haokun12x/best-key/README.md

# BK46 — 46 键正交 / 双直驱力反馈旋钮 / TMR + 机械轴共用 / 三模 / 无线充电

> **当前状态：外壳、主板、两块旋钮小板的制作文件齐全。三块板都已 100% 布通，KiCad DRC 零错误、零未连接（主板只剩 7 处元件占位框重叠的警告）。固件未写，电子部分整体未经打样验证，BOM 编号需核对。** 详见文末「完成度与待办」。

## 1. 方案总览

| 项目 | 方案 |
|---|---|
| 配列 | 4×12 正交网格，19.05 mm 间距；左上角、右上角两格换成旋钮，共 46 键 |
| 外形 | 237.2 × 84.8 × 19.8 mm（不含脚垫），四周只比键区多 4.3 mm，圆角 R4 |
| 轴体 | 每键同时有 Kailh 热插拔座（三脚/五脚机械轴）和一颗 SOT-23 线性磁传感器（磁轴） |
| 旋钮 | 2 个，1404 级无刷外转子电机直驱 + STSPIN233 驱动 + MT6701 磁编码器；带模拟量下压识别，咔哒与震动由电机模拟 |
| RGB | 每键一颗 WS2812B-2020，正面贴装在轴体灯位，整条灯带电源可关断 |
| 显示 | 0.91" 128×32 OLED（SSD1306，38×12 mm 成品模块），嵌在前壁中央 |
| 主控 | Raytac MDBT50Q-1MV2（nRF52840）：USB、蓝牙、2.4G（配 nRF52840 接收器） |
| 固件 | RMK（用 Vial 上位机改键/层/宏）或 ZMK；**不能刷 QMK / Vial-QMK**；预留 W25Q32 外置闪存。移植要点见 `docs/firmware.md` |
| 电源 | USB-C 或 Qi 5 V 接收模块 → BQ24075 充电与路径管理 → 304060 锂电（约 800 mAh）→ XC6206 3.3 V |
| 结构 | 底壳 + 上框两件式，定位板上下各 15 段 Poron 垫片夹持（gasket），底部 8 颗 M2×18 沉头螺丝 |
| 重量 | 尼龙打印外壳约 65 g（底壳 53 + 上框 12）；FR4 定位板约 24 g |

相对最初想法的改动：

- **旋钮**：真正的侧面表冠放不下任何现成直驱电机（除非凸出约 7 mm），最终按你的决定改为左右上角各一个立式旋钮。
- **下压**：不做有行程的按压机构（1u 空间里会晃）。电机座是小板上由 4 根 FR4 梁悬挂的小岛，按压时下沉几十微米，由背面轴心的磁传感器测出，输出模拟量，接到主板复用器空余的两路。没有采用 MT6701 自带的按钮功能，因为它需要零点几毫米的轴向行程。
- **显示屏**：按你的想法放在朝向用户的前壁。从上方看是斜视角，所以选了视角最宽的 OLED。
- **无线充电**：用成品 Qi 接收贴片（线圈 + 小板，输出 5 V），焊到主板 `QI5V`/`GND` 两个焊盘，不自己设计接收电路。

## 2. 叠层（Z 向，单位 mm，从底面算起）

图：`mech/out/drawings/00_stackup_section.svg`

| 高度 | 内容 |
|---|---|
| 0 – 1.6 | 底壳底板 |
| 1.6 – 7.2 | 腔体 5.6：电池 3.2、Qi 线圈约 1.3、热插拔座向下 1.85；旋钮小板 0.6 厚，垫高 0.4（2.0 – 2.6） |
| 7.2 – 8.8 | 主板 1.6（4 层） |
| 8.8 – 12.3 | 轴体下壳 / 夹心棉 3.5 |
| 11.1 | 底壳垫片台顶面 |
| 12.3 – 13.8 | 定位板 1.5（FR4 / PC / 铝均可） |
| 15.0 | 底壳与上框分界面，上框压边底面 |
| 15.0 – 19.8 | 上框 |
| 3.8 – 17.3 | 电机（座在 0.6 小板 + 1.2 垫片上） |
| 17.6 – 31.0 | 旋钮帽，直径 18.6 |

垫片：1.5 mm 厚 Poron 条，宽 1.5 mm，贴在定位板边缘正反两面，压缩到 1.2 mm。位置见 `05_gasket_positions_x2.dxf`。

## 3. 文件清单

```
index.html                  项目主页（逐层拆解展示，可直接用 GitHub Pages 从仓库根目录发布）
site/render/, render_previews.py   主页用的外壳线稿及生成脚本
mech/params.py              所有机械尺寸的唯一来源
mech/build_case.py          外壳 CAD 脚本（CadQuery），含干涉检查
mech/build_drawings.py      各层 DXF 图纸与叠层剖面图
mech/out/*.step, *.stl      底壳 tub、上框 bezel、定位板 plate、旋钮帽 knob_cap、旋钮芯 knob_core、电机垫片 motor_spacer
mech/out/bk46_assembly.step 总装（含 PCB、电池、线圈、电机、键帽包络等参考体）
mech/out/drawings/          00 叠层剖面  01 定位板  02 上框  03/04 底壳剖面与底孔  05 垫片位置  06 夹心棉  07 腔内布局
pcb/main/bk46_main.kicad_pcb / .kicad_pro   主板（4 层 1.6 mm）
pcb/main/unconnected.txt    主板连通状态（现为全部连通）
pcb/main/fab/               主板 Gerber、钻孔、贴片坐标、四层铜 SVG
pcb/main/bom_main.csv, keymap.json, netlist.json, drc.json
pcb/knob/L, pcb/knob/R      左、右旋钮小板（2 层 0.6 mm），各含 KiCad 工程和 fab/ 制板文件
pcb/knob/bom_knob.csv, ffc_pinmap.json
pcb/gen_main.py, gen_knob.py, router.py   板子的生成脚本和自写布线器
docs/firmware.md            固件移植说明：扫描、力反馈效果、下压识别、引脚
analysis/tmr_field.py, .svg 磁轴磁场仿真
tools/                      kpy.sh（KiCad 自带 Python）、drc.sh、freeroute.py（调用 Freerouting）、write_pro.py、sympins.py、
                            patch_route.py（拆线重布补线器）、clean_dangling.py（清悬空线）、finish_main.sh（主板收尾流程）
```

重新生成（主板约 2 分钟）：

```bash
.venv/bin/python mech/build_case.py
```
```bash
tools/kpy.sh pcb/gen_main.py
```
生成器自身会剩几处连不上的线，再用收尾流程补完（约 35 分钟，结果写到 `pcb/main_fin/`，确认后复制回 `pcb/main/`）：
```bash
tools/finish_main.sh pcb/main/bk46_main.kicad_pcb pcb/main_fin
```
```bash
tools/kpy.sh pcb/gen_knob.py
```
```bash
tools/kpy.sh tools/freeroute.py pcb/knob/L/bk46_knob_L_unrouted.kicad_pcb pcb/knob/L/bk46_knob_L.kicad_pcb 200 --zones=GND:F.Cu,GND:B.Cu
```

## 4. 电路架构

### 4.1 按键扫描（机械轴、磁轴、旋钮下压共用一条链路）

- 每键：传感器 OUT →10 kΩ→ `KEY` 节点 → CD74HC4067 的一路输入；热插拔座一脚接 `KEY`，另一脚接地。
- 装磁轴时 `KEY` 跟随传感器输出，读到模拟行程；装机械轴时按下把 `KEY` 拉到 0 V。固件校准时自动判定每个键是哪种轴。
- 没有二极管矩阵，天然全键无冲。3 颗 16 选 1 复用器共 48 路：46 个键 + 2 个旋钮下压。
- 传感器电源由 P-MOS 开关控制，空闲时低频间歇上电。
- 第 1、3 行轴体旋转 180°，使 PCB 前缘、后缘和中间各空出一条没有热插拔座的带状区域放元件。

### 4.2 主控引脚

| 功能 | 引脚 | 功能 | 引脚 |
|---|---|---|---|
| MUXA / MUXB / MUXC（ADC） | P0.29 / P0.31 / P0.30 | 电池电压 | P0.04 |
| 复用器 S0–S3 | P0.27, P0.06, P0.08, P1.09 | 传感器电源使能（低有效） | P1.12 |
| 左旋钮三相 PWM | P1.10, P1.11, P1.13 | 右旋钮三相 PWM | P0.13, P0.15, P0.17 |
| 编码器 CLK / DO（共用） | P0.22 / P0.24 | 编码器片选 左 / 右 | P1.15 / P0.20 |
| 旋钮电源使能（低有效） | P0.19 | 充电状态 | P0.03 |
| LED 数据 | P0.23 | LED 电源使能（高有效） | P1.14 |
| OLED SDA / SCL | P0.14 / P0.16 | 复位 | P0.18 |
| 外置闪存 CS / CLK / MOSI / MISO | P0.02 / P0.28 / P0.26 / P0.05 | | |

每个键的复用器通道和 LED 序号在 `pcb/main/keymap.json`。旋钮下压：左 = 复用器 A 通道 0，右 = 复用器 C 通道 15。

### 4.3 旋钮模块

- **小板**：0.6 mm 双层板。电机座是 13 mm 见方的小岛，四边各由一座 3 mm 宽的桥连到 2 mm 宽的 FR4 梁上，梁两端在四角用螺丝固定在底壳凸台上。估算刚度约 190 N/mm，4 N 按压下沉约 0.02 mm，未实测。
- **角度**：MT6701QT 在小岛正面轴心，对着粘在电机轴底的径向磁铁。
- **下压**：Z 向线性磁传感器（SOT-23）在小岛背面轴心，对着粘在底壳孔里的 Ø3×0.5 磁铁。
- **驱动**：STSPIN233 在小板尾部；使能脚固定上拉到旋钮电源，整路由主板的 P-MOS 开关控制。
- **排线**：14P 0.5 mm 同向 FFC，约 30 mm。主板连接器朝后壁出线，排线向下折 180° 插入正下方的小板连接器。引脚自西向东（左旋钮）：`VSYS ×3, GND ×3, K3V3, U, V, W, PRESS, CSN, CLK, DO`；右旋钮镜像。
- 电机三相线焊在小板的 M1–M3 焊盘。
- 力反馈效果、下压算法和低功耗策略见 `docs/firmware.md`。

## 5. 外购件

| 件 | 规格 | 数量 |
|---|---|---|
| 电机 | 1404 级无刷外转子，机身 ≤ Ø18.9 × 13.5，底部 4×M2（9×9 mm），T 型桨座（2×M2 间距 5 mm） | 2 |
| 径向充磁磁铁 | Ø4×2，粘在电机轴底端 | 2 |
| 轴向充磁磁铁 | Ø3×0.5，粘在底壳电机轴心孔内，与底面齐平 | 2 |
| OLED | 0.91" SSD1306 I2C 模块，PCB 38×12 | 1 |
| 电池 | 304060 锂聚合物，带保护板，JST-SH 2P（核对极性） | 1 |
| Qi 接收 | 5 V 成品接收贴片，线圈 ≤ 48×34 | 1 |
| FFC | 14P 0.5 mm 同向，30 mm | 2 |
| 螺丝 | M2×18 沉头（上框）×8；M2×4 盘头（电机，从小板背面拧入）×8；M2×3 自攻（小板固定）×10；M2×3（定位板铜柱）×20；M2×4（旋钮帽芯）×4 | |
| 铜柱 | M2×3.5 双通 | 10 |
| 垫片 | 1.5 mm Poron，裁 1.5 mm 宽 | 30 段 |
| 接收器 | nRF52840 USB Dongle（2.4G 模式用） | 1 |

主板元件见 `pcb/main/bom_main.csv`，小板见 `pcb/knob/bom_knob.csv`。立创编号是凭记忆填的，下单前必须逐个核对。

## 6. 装配顺序

1. 旋钮模块：电机垫片夹在小板和电机之间，4 颗 M2×4 从小板背面拧进电机底座；径向磁铁粘在轴底。
2. Ø3×0.5 磁铁粘进底壳轴心孔。把旋钮模块放到底壳凸台上，四角 4 颗、尾部 1 颗自攻螺丝固定。电机螺丝头落在底壳的让位孔里，不能碰到孔壁。
3. OLED 模块从上方滑入前壁口袋固定；电池、Qi 线圈贴在底板上（位置见 `07_floor_layout.dxf`）。
4. 主板与定位板用 10 根 3.5 mm 铜柱连接，装轴，定位板边缘正反贴垫片。
5. 接好两条排线、电池、Qi、OLED 四根线，USB 一端先斜插进后壁开口，再放平。
6. 盖上框，从底面拧 8 颗 M2×18。尼龙上框用自攻方式（底孔 Ø1.7），铝上框攻 M2 牙。
7. 旋钮芯用 2 颗 M2 拧在电机转子上，压上旋钮帽。

维修时拆 8 颗底部螺丝，上框可带着键帽直接提起，内胆随后取出。

## 7. 完成度与待办

### 已验证

- 外壳各零件与 PCB、电机、电池、线圈、显示模块、键帽包络之间的干涉检查全部为 0。
- 左、右旋钮小板：100% 布通，KiCad DRC 零违规、零未连接。
- 主板：100% 布通，KiCad DRC 零错误、零未连接、零悬空线、零孔距问题（间距规则 0.10 mm，最细线 0.15 mm，过孔 0.45/0.20 mm，属 4 层板常规工艺）。剩 7 处元件占位框重叠警告（两个 FFC 座与旁边阻容、C1/C2、C3 与 J1/U138），焊盘之间不冲突，贴片前看一眼即可。
- 所有 IC 的引脚定义取自 KiCad 官方符号库。

### 主板收尾时做的取舍

- 主控模块内圈焊盘之间只容得下 0.15 mm 线，所以补线统一用 0.15 mm；电源网络（VSYS、VBUS、VBAT、K3V3、VSENSE）重布时保持原线宽，VSYS 仍为 0.5 mm。
- 部分 +3V3 走线由 0.25 mm 换成了 0.15 mm（总电流约 0.2 A 以内，压降估计 30 mV 量级）。
- `CHG`、`SWDIO` 和一小段 +3V3 共约 13 mm 走在 In1 地平面上，地平面上因此有几条短缝，对这块板的信号影响很小。
- 删掉了 15 个与其他孔重叠或间距不足的 GND/VLED 过孔（地和 LED 电源有整层平面，连通性已由 DRC 复核）。

### 未完成

1. 没有原理图，网表以生成脚本和 `netlist.json` 为准。
2. 固件未写；`docs/firmware.md` 是移植说明，不是代码。
3. BOM 里的立创编号凭记忆填写，下单前逐个核对。

### 需要打样验证的风险

1. **按键传感器选型（最重要）**。传感器在轴心南侧 3.5 mm。`analysis/tmr_field.py` 的仿真结果：

   | 传感方式 | 释放 → 触底场强 | 是否单调 | 触底前 0.5 mm 的斜率 |
   |---|---|---|---|
   | 轴心正下方 Z 向（纯磁轴板的做法） | 9.6 → 58 mT | 是 | 33 mT/mm |
   | 偏 3.5 mm，Z 向（如 TMR2617S） | 5.4 → 10.3 mT | 否 | 0.4 mT/mm |
   | 偏 3.5 mm，面内径向 | 4.1 → 19.5 mT | 是 | 8.1 mT/mm |

   应选**面内感应**的线性 TMR，敏感轴指向轴心。BOM 里暂填的 TMR2617S 是 Z 向的，在这个位置触底前约 0.7 mm 分辨不出行程。我没能确认具体的面内型号，磁铁尺寸也是假设值，建议先做 2×2 小板验证；若所选传感器敏感轴方向不同，封装要转 90°。
2. **旋钮下压灵敏度**。梁的刚度和磁场梯度都是估算，按 4 N 约 1 mT 的信号量级设计；实际偏小可把小板换成 0.4 mm 或把梁铣窄，偏大则加厚。电机磁钢对下压传感器的串扰未评估。
3. **MT6701 的 MODE 脚**按"接地 = SSI/I2C"连接，需对照手册确认。
4. **力反馈强度**约 5 mN·m 是按电机参数估算的。电机相电阻很低，固件必须限流。
5. **左旋钮 PWM 用了 P1.10/P1.11/P1.13**，属于芯片的低频引脚，出力时可能影响蓝牙灵敏度。
6. **电机尺寸**因品牌而异，`params.py` 里 `MOTOR_*` 要按实物改。
7. **RGB 供电**直接用电池电压，电量低时蓝绿光偏暗；固件要限制总电流。
8. **无线充电**的交变磁场和带磁吸的充电座会干扰磁传感器。
9. **天线**在板子中部，周围是铺铜和金属轴座，蓝牙距离会打折扣。
10. **显示模块**的显示区偏移因厂家而异，`DISP_WIN_DX` 要按实物量。
11. **正贴 2020 灯珠**能否放进轴体灯槽取决于轴体，放不下可换 1.5×1.5 的 SK6805-EC15。
12. 0.6 mm 的旋钮小板较软，贴片时需要托板。
