haokun12x/best-key/pcb/main/unconnected.txt

主板：全部连通（KiCad DRC 0 错误、0 未连接、0 悬空线、0 孔距问题）。
剩余仅有 7 处 courtyards_overlap 警告（元件占位框相互重叠，焊盘之间无冲突）。
