haokun12x/best-key/mech/out/bk46_assembly.step

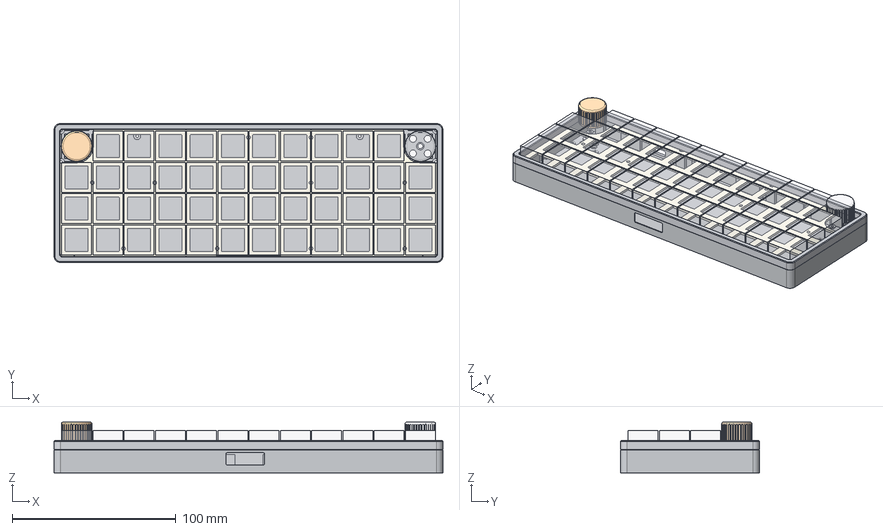
[picture p1: CAD file, 2026-11-12]
mech/out/bk46_assembly.step
237.2 x 84.8 x 31.0 mm
tub_part
bezel_part
plate_part
motor_spacer_part
knob_core_part
knob_cap_part
pcb_ref_part
sockets_ref_part
knob_cap_R_part
knob_core_R_part
motor_spacer_R_part
motor_ref_part
knob_pcb_ref_part
display_ref_part
battery_ref_part
qi_coil_ref_part
keycaps_ref_part
