haokun12x/best-key/mech/out/drawings/02_bezel_top_view.dxf

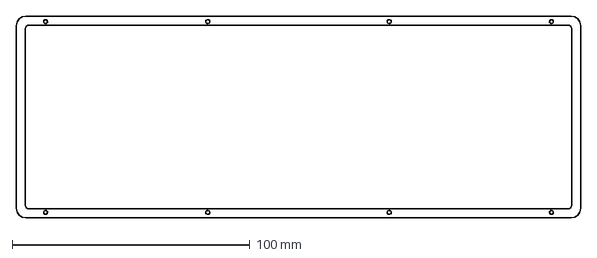
[picture p2: CAD file, 2026-11-12]
mech/out/drawings/02_bezel_top_view.dxf
237.2 x 84.8 mm
