haokun12x/best-key/mech/out/drawings/03_tub_section_z4.6.dxf

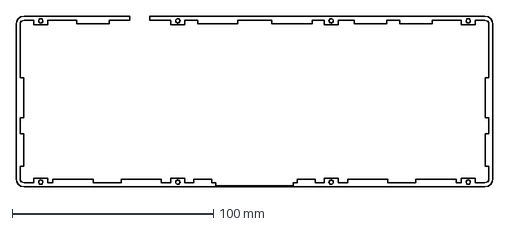
[picture p3: CAD file, 2026-11-12]
mech/out/drawings/03_tub_section_z4.6.dxf
237.2 x 84.8 mm
