haokun12x/best-key/mech/out/plate.step

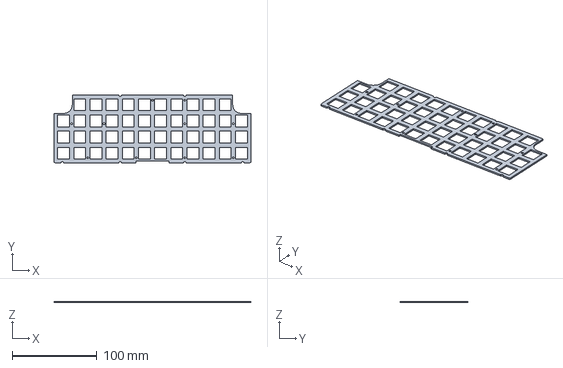
[picture p4: CAD file, 2026-11-12]
mech/out/plate.step
232.2 x 79.8 x 1.50 mm
