haokun12x/best-key/mech/out/drawings/07_floor_layout.dxf

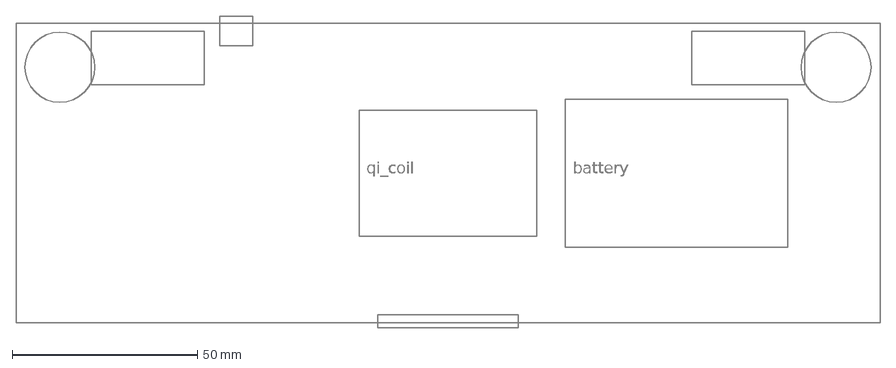
[picture p5: CAD file, 2026-11-12]
mech/out/drawings/07_floor_layout.dxf
battery
qi_coil
