haokun12x/best-key/mech/out/knob_core.step

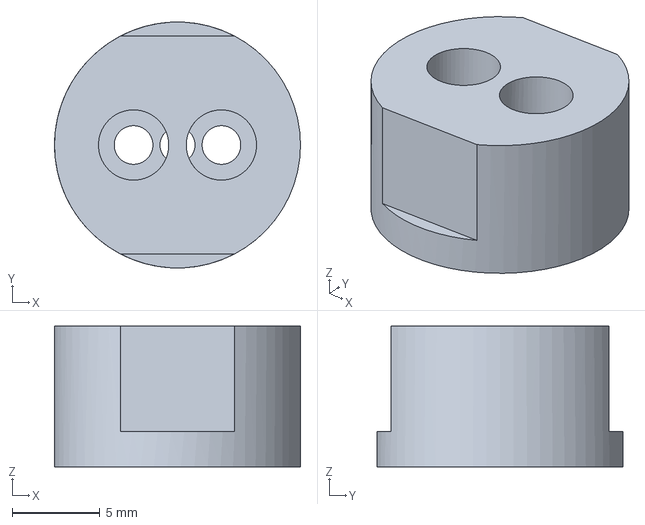
[picture p6: CAD file, 2026-11-12]
mech/out/knob_core.step
14.0 x 14.0 x 8.00 mm
