haokun12x/best-key/mech/out/drawings/06_plate_foam_3mm.dxf

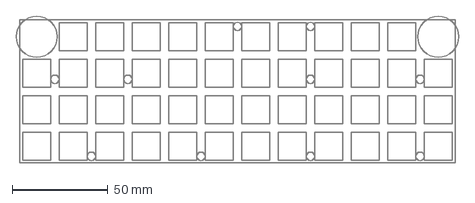
[picture p7: CAD file, 2026-11-12]
mech/out/drawings/06_plate_foam_3mm.dxf
231.0 x 76.6 mm
