haokun12x/best-key/mech/out/knob_cap.step

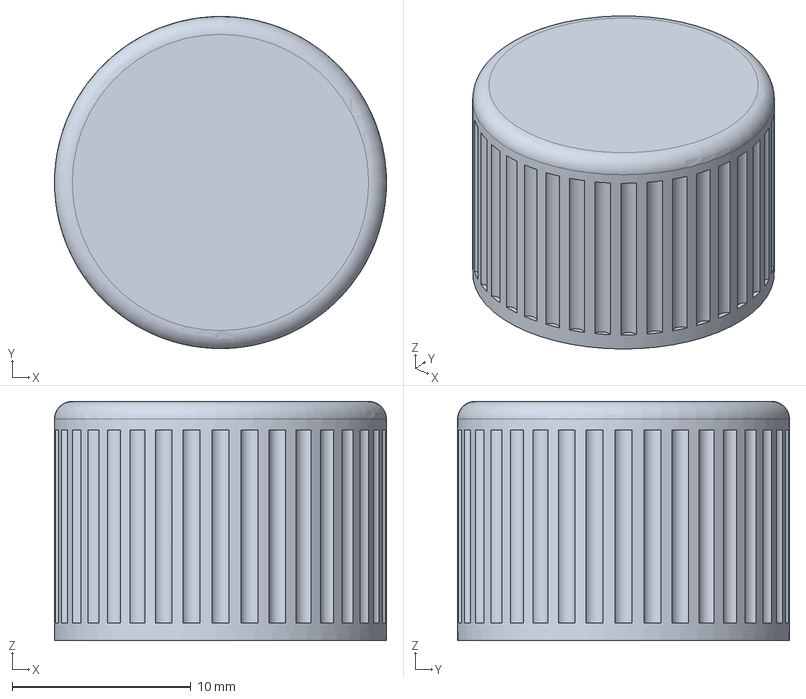
[picture p8: CAD file, 2026-11-12]
mech/out/knob_cap.step
18.6 x 18.6 x 13.4 mm
