haokun12x/best-key/mech/out/drawings/01_plate_1.5mm.dxf

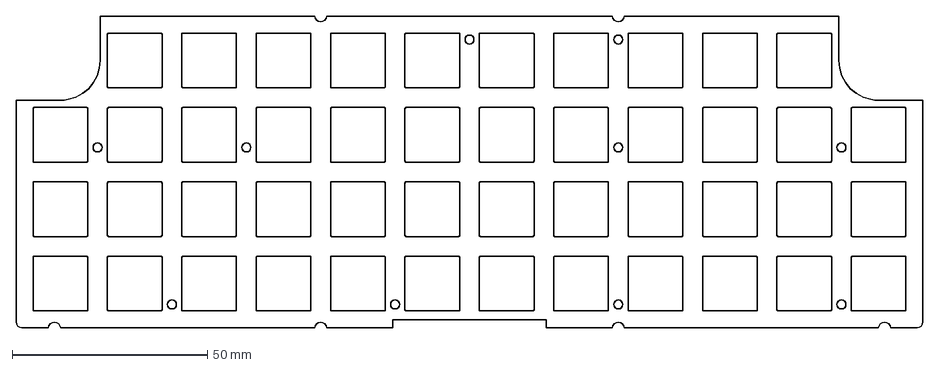
[picture p9: CAD file, 2026-11-12]
mech/out/drawings/01_plate_1.5mm.dxf
232.2 x 79.8 mm
