haokun12x/best-key/mech/out/motor_spacer.step

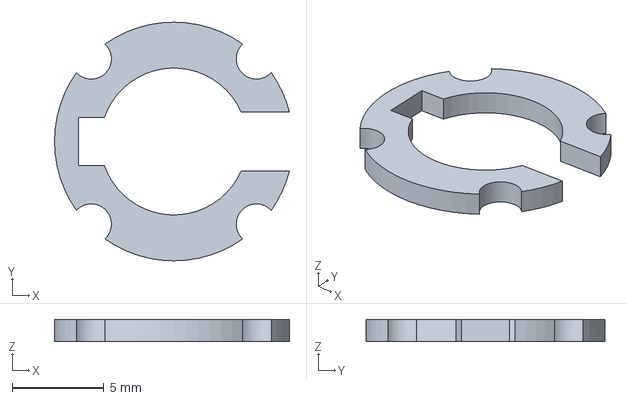
[picture p10: CAD file, 2026-11-12]
mech/out/motor_spacer.step
12.8 x 13.0 x 1.20 mm
