haokun12x/best-key/mech/out/bezel.step

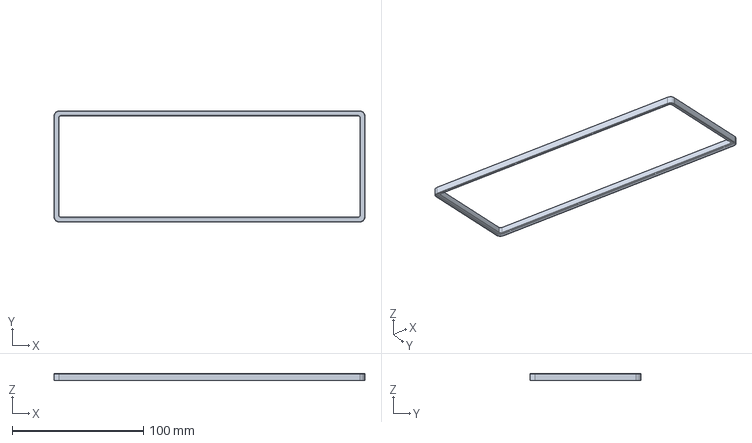
[picture p11: CAD file, 2026-11-12]
mech/out/bezel.step
237.2 x 84.8 x 5.65 mm
