haokun12x/best-key/mech/out/drawings/05_gasket_positions_x2.dxf

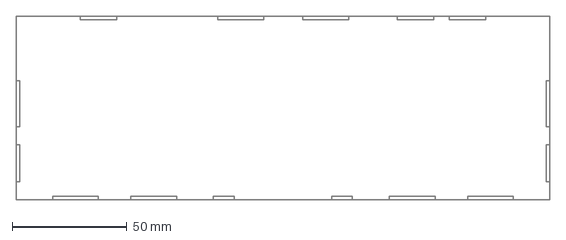
[picture p12: CAD file, 2026-11-12]
mech/out/drawings/05_gasket_positions_x2.dxf
232.2 x 79.8 mm
