haokun12x/best-key/mech/out/drawings/04_tub_floor_holes.dxf

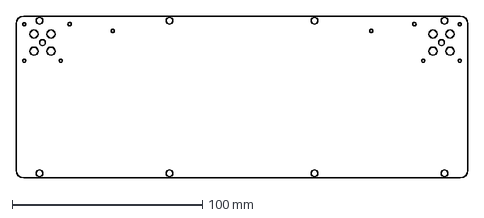
[picture p13: CAD file, 2026-11-12]
mech/out/drawings/04_tub_floor_holes.dxf
237.2 x 84.8 mm
