haokun12x/best-key/mech/out/tub.step

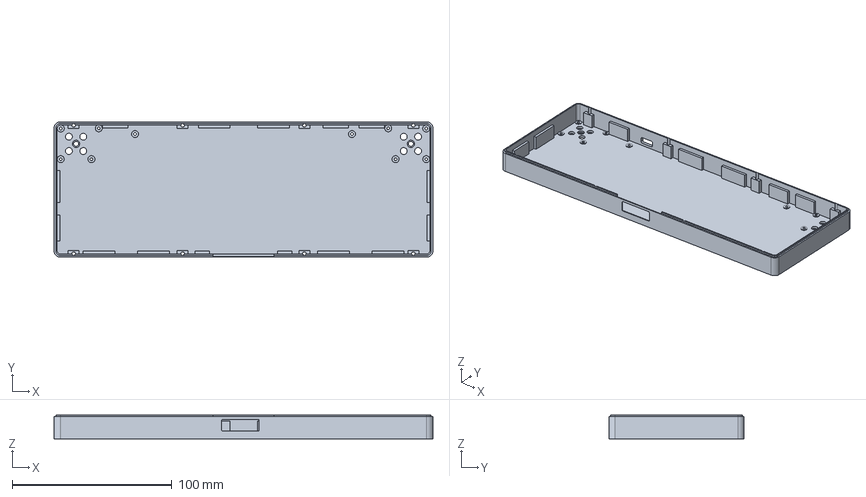
[picture p14: CAD file, 2026-11-12]
mech/out/tub.step
237.2 x 84.8 x 15.0 mm
