haokun12x/best-key/(list of files, cad)

Other CAD files:
mech/out/bezel.stl
mech/out/knob_cap.stl
mech/out/knob_core.stl
mech/out/motor_spacer.stl
mech/out/plate.stl
mech/out/tub.stl
