haokun12x/best-key/(list of files, drawings)

Other design files:
pcb/knob/L/bk46_knob_L.dsn
pcb/knob/R/bk46_knob_R.dsn
