haokun12x/best-key/pcb/main/bk46_main.kicad_pcb

## KiCad design pcb/main/bk46_main.kicad_pcb (2026-11-12)

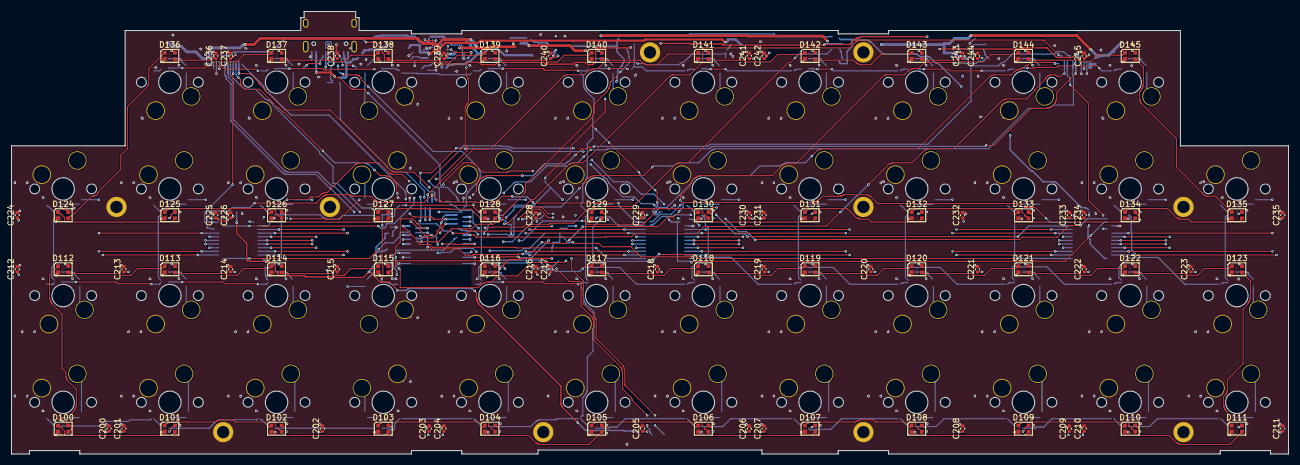
[picture p15: board bk46_main.kicad_pcb from above]

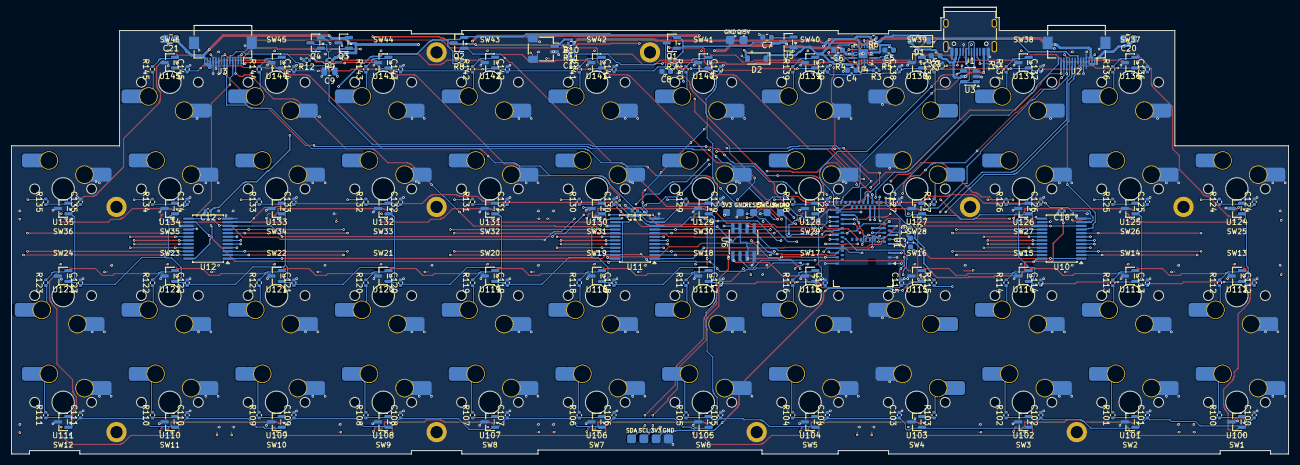
[picture p16: board bk46_main.kicad_pcb from below]

Board: 4 copper layers, 228.0 x 79.0 mm, 341 parts (183 on the bottom side), 190 nets.

Parts:
C1, C10, C11, C12, C12#2, C200, C201, C202, C203, C204, C205, C206, C207, C208, C209, C210, C211, C212, C213, C214, C215, C216, C217, C218, C219, C220, C221, C222, C223, C224, C225, C226, C228, C229, C230, C231, C232, C233, C234, C235, C236, C237, C238, C239, C240, C241, C242, C243, C244, C245: 100n; C_0402_1005Metric
C2, C3, C5, C6: 4u7; C_0603_1608Metric
C4, C7, C8: 1u; C_0603_1608Metric
C9: 10u; C_0805_2012Metric
C20, C21: 22u; C_0805_2012Metric
C100, C101, C102, C103, C104, C105, C106, C107, C108, C109, C110, C111, C112, C113, C114, C115, C116, C117, C118, C119, C120, C121, C122, C123, C124, C125, C126, C127, C128, C129, C130, C131, C132, C133, C134, C135, C136, C137, C138, C139, C140, C141, C142, C143, C144, C145: 22n; C_0402_1005Metric
D1, D2: B5819W; D_SOD-123
D100, D101, D102, D103, D104, D105, D106, D107, D108, D109, D110, D111, D112, D113, D114, D115, D116, D117, D118, D119, D120, D121, D122, D123, D124, D125, D126, D127, D128, D129, D130, D131, D132, D133, D134, D135, D136, D137, D138, D139, D140, D141, D142, D143, D144, D145: WS2812B-2020; LED_WS2812B-2020_PLCC4_2.0x2.0mm
H1, H2, H3, H4, H5, H6, H7, H8, H9, H10: M2 standoff 3.5mm
J1: USB-C 16P; USB_C_Receptacle_HRO_TYPE-C-31-M-12
J2, J3: FFC 14P 0.5mm; Hirose_FH12-14S-0.5SH_1x14-1MP_P0.50mm_Horizontal
J4: BAT (JST-SH 2P); JST_SH_SM02B-SRSS-TB_1x02-1MP_P1.00mm_Horizontal
Q1, Q2, Q3: AO3401A; SOT-23
Q4: 2N7002; SOT-23
R1, R2: 5k1; R_0402_1005Metric
R3: 2k2; R_0402_1005Metric
R4: 1k5; R_0402_1005Metric
R5, R6, R100, R101, R102, R103, R104, R105, R106, R107, R108, R109, R110, R111, R112, R113, R114, R115, R116, R117, R118, R119, R120, R121, R122, R123, R124, R125, R126, R127, R128, R129, R130, R131, R132, R133, R134, R135, R136, R137, R138, R139, R140, R141, R142, R143, R144, R145: 10k; R_0402_1005Metric
R7, R8, R9, R12: 100k; R_0402_1005Metric
R10, R11: 1M; R_0402_1005Metric
SW1, SW2, SW3, SW4, SW5, SW6, SW7, SW8, SW9, SW10, SW11, SW12, SW13, SW14, SW15, SW16, SW17, SW18, SW19, SW20, SW21, SW22, SW23, SW24, SW25, SW26, SW27, SW28, SW29, SW30, SW31, SW32, SW33, SW34, SW35, SW36, SW37, SW38, SW39, SW40, SW41, SW42, SW43, SW44, SW45, SW46: MX_HS_TMR
TP1: QI5V
TP2, TP10, TP23: GND
TP11, TP24: +3V3
TP12: SCL
TP13: SDA
TP20: SWDIO
TP21: SWCLK
TP22: RESET
U1: MDBT50Q-1MV2; Raytac_MDBT50Q
U3: USBLC6-2SC6; SOT-23-6
U4: BQ24075RGT; VQFN-16-1EP_3x3mm_P0.5mm_EP1.6x1.6mm
U5: XC6206P332MR; SOT-23
U6: W25Q32JVSSIQ (optional); SOIC-8_3.9x4.9mm_P1.27mm
U10, U11, U12: CD74HC4067SM96; SSOP-24_5.3x8.2mm_P0.65mm
U100, U101, U102, U103, U104, U105, U106, U107, U108, U109, U110, U111, U112, U113, U114, U115, U116, U117, U118, U119, U120, U121, U122, U123, U124, U125, U126, U127, U128, U129, U130, U131, U132, U133, U134, U135, U136, U137, U138, U139, U140, U141, U142, U143, U144, U145: TMR2617S; SOT-23

Connections:
+3V3: C1.1, C2.1, C7.1, C10.1, C11.1, C12#2.1, Q1.2, Q2.2, R7.1, R8.1, TP11.1, TP24.1, U1.28, U1.30, U5.2, U6.3, U6.7, U6.8, U10.24, U11.24, U12.24
CC1: J1.A5, R1.1
CC2: J1.B5, R2.1
CHG: U1.9, U4.9
EN1: R6.1, U4.6
ENC_CLK: J2.13, J3.2, U1.46
ENC_CSN1: J2.12, U1.8
ENC_CSN2: J3.3, U1.44
ENC_DO: J2.14, J3.1, U1.48
FL_CLK: U1.13, U6.6
FL_CS: U1.11, U6.1
FL_MISO: U1.21, U6.2
FL_MOSI: U1.19, U6.5
GND: C1.2, C2.2, C3.2, C4.2, C5.2, C6.2, C7.2, C8.2, C9.2, C10.2, C11.2, C12.2, C12#2.2, C20.2, C21.2, C100.2, C101.2, C102.2, C103.2, C104.2, C105.2, C106.2, C107.2, C108.2, C109.2, C110.2, C111.2, C112.2, C113.2, C114.2, C115.2, C116.2, C117.2, C118.2, C119.2, C120.2, C121.2, C122.2, C123.2, C124.2, C125.2, C126.2, C127.2, C128.2, C129.2, C130.2, C131.2, C132.2, C133.2, C134.2, C135.2, C136.2, C137.2, C138.2, C139.2, C140.2, C141.2, C142.2, C143.2, C144.2, C145.2, C200.2, C201.2, C202.2, C203.2, C204.2, C205.2, C206.2, C207.2, C208.2, C209.2, C210.2, C211.2, C212.2, C213.2, C214.2, C215.2, C216.2, C217.2, C218.2, C219.2, C220.2, C221.2, C222.2, C223.2, C224.2, C225.2, C226.2, C228.2, C229.2, C230.2, C231.2, C232.2, C233.2, C234.2, C235.2, C236.2, C237.2, C238.2, C239.2, C240.2, C241.2, C242.2, C243.2, C244.2, C245.2, D100.2, D101.2, D102.2, D103.2, D104.2, D105.2, D106.2, D107.2, D108.2, D109.2, D110.2, D111.2, D112.2, D113.2, D114.2, D115.2, D116.2, D117.2, D118.2, D119.2, D120.2, D121.2, D122.2, D123.2, D124.2, D125.2, D126.2, D127.2, D128.2, D129.2, D130.2, D131.2, D132.2, D133.2, D134.2, D135.2, D136.2, D137.2, D138.2, D139.2, D140.2, D141.2, D142.2, D143.2, D144.2, D145.2, H1.1, H2.1, H3.1, H4.1, H5.1, H6.1, H7.1, H8.1, H9.1, H10.1, J1.A1, J1.A12, J1.B1, J1.B12, J1.SH, J2.4, J2.5, J2.6, J2.MP, J3.9, J3.10, J3.11, J3.MP, J4.2, J4.MP, Q4.2, R1.2, R2.2, R3.2, R4.2, R5.2, R11.2, R12.2, SW1.1, SW2.1, SW3.1, SW4.2, SW5.1, SW6.1, SW7.1, SW8.1, SW9.1, SW10.1, SW11.1, SW12.1, SW13.2, SW14.2, SW15.2, SW16.1, SW17.2, SW18.2, SW19.2, SW20.2, SW21.2, SW22.2, SW23.2, SW24.2, SW25.1, SW26.1, SW27.1, SW28.2, SW29.1, SW30.1, SW31.1, SW32.1, SW33.1, SW34.1, SW35.1, SW36.1, SW37.2, SW38.2, SW39.1, SW40.2, SW41.2, SW42.2, SW43.2, SW44.2, SW45.2, SW46.2, TP2.1, TP10.1, TP23.1, U1.1, U1.2, U1.15, U1.33, U1.55, U3.2, U4.4, U4.5, U4.8, U4.15, U4.17, U5.1, U6.4, U10.12, U10.15, U11.12, U11.15, U12.12, U12.15, U100.3, U101.3, U102.3, U103.3, U104.3, U105.3, U106.3, U107.3, U108.3, U109.3, U110.3, U111.3, U112.3, U113.3, U114.3, U115.3, U116.3, U117.3, U118.3, U119.3, U120.3, U121.3, U122.3, U123.3, U124.3, U125.3, U126.3, U127.3, U128.3, U129.3, U130.3, U131.3, U132.3, U133.3, U134.3, U135.3, U136.3, U137.3, U138.3, U139.3, U140.3, U141.3, U142.3, U143.3, U144.3, U145.3
ILIM: R4.1, U4.12
ISET: R3.1, U4.16
K1U: J2.8, U1.3
K1V: J2.9, U1.4
K1W: J2.10, U1.6
K2U: J3.7, U1.37
K2V: J3.6, U1.39
K2W: J3.5, U1.41
K3V3: J2.7, J3.8, Q2.3
KEY_0_0: R100.2, SW1.2, U10.2
KEY_0_1: R112.1, SW13.1, U10.3
KEY_0_2: R124.2, SW25.2, U10.8
KEY_1_0: R101.2, SW2.2, U10.4
KEY_1_1: R113.1, SW14.1, U10.5
KEY_1_2: R125.2, SW26.2, U10.6
KEY_1_3: R136.1, SW37.1, U10.7
KEY_2_0: R102.2, SW3.2, U10.21
KEY_2_1: R114.1, SW15.1, U10.20
KEY_2_2: R126.2, SW27.2, U10.19
KEY_2_3: R137.1, SW38.1, U10.18
KEY_3_0: R103.2, SW4.1, U10.23
KEY_3_1: R115.1, SW16.2, U10.22
KEY_3_2: R127.2, SW28.1, U10.17
KEY_3_3: R138.1, SW39.2, U10.16
KEY_4_0: R104.2, SW5.2, U11.2
KEY_4_1: R116.1, SW17.1, U11.3
KEY_4_2: R128.2, SW29.2, U11.8
KEY_4_3: R139.1, SW40.1, U11.9
KEY_5_0: R105.2, SW6.2, U11.4
KEY_5_1: R117.1, SW18.1, U11.5
KEY_5_2: R129.2, SW30.2, U11.6
KEY_5_3: R140.1, SW41.1, U11.7
KEY_6_0: R106.2, SW7.2, U11.21
KEY_6_1: R118.1, SW19.1, U11.20
KEY_6_2: R130.2, SW31.2, U11.19
KEY_6_3: R141.1, SW42.1, U11.18
KEY_7_0: R107.2, SW8.2, U11.23
KEY_7_1: R119.1, SW20.1, U11.22
KEY_7_2: R131.2, SW32.2, U11.17
KEY_7_3: R142.1, SW43.1, U11.16
KEY_8_0: R108.2, SW9.2, U12.2
KEY_8_1: R120.1, SW21.1, U12.3
KEY_8_2: R132.2, SW33.2, U12.8
KEY_8_3: R143.1, SW44.1, U12.9
KEY_9_0: R109.2, SW10.2, U12.4
KEY_9_1: R121.1, SW22.1, U12.5
KEY_9_2: R133.2, SW34.2, U12.6
KEY_9_3: R144.1, SW45.1, U12.7
KEY_10_0: R110.2, SW11.2, U12.21
KEY_10_1: R122.1, SW23.1, U12.20
KEY_10_2: R134.2, SW35.2, U12.19
KEY_10_3: R145.1, SW46.1, U12.18
KEY_11_0: R111.2, SW12.2, U12.23
KEY_11_1: R123.1, SW24.1, U12.22
KEY_11_2: R135.2, SW36.2, U12.17
KNOB_PWR_EN: Q2.1, R8.2, U1.42
LD1: D115.3, D116.1
LD2: D114.3, D115.1
LD3: D113.3, D114.1
LD4: D112.3, D113.1
LD5: D100.3, D112.1
LD6: D100.1, D101.3
LD7: D101.1, D102.3
LD8: D102.1, D103.3
LD9: D103.1, D104.3
LD10: D104.1, D105.3
LD11: D105.1, D106.3
LD12: D106.1, D107.3
LD13: D107.1, D108.3
LD14: D108.1, D109.3
LD15: D109.1, D110.3
LD16: D110.1, D111.3
LD17: D111.1, D123.3
LD18: D122.3, D123.1
LD19: D121.3, D122.1
LD20: D120.3, D121.1
LD21: D119.3, D120.1
LD22: D118.3, D119.1
LD23: D117.3, D118.1
LD24: D117.1, D129.3
LD25: D129.1, D130.3
LD26: D130.1, D131.3
LD27: D131.1, D132.3
LD28: D132.1, D133.3
LD29: D133.1, D134.3
LD30: D134.1, D135.3
LD31: D135.1, D145.3
LD32: D144.3, D145.1
LD33: D143.3, D144.1
LD34: D142.3, D143.1
LD35: D141.3, D142.1
LD36: D140.3, D141.1
LD37: D139.3, D140.1
LD38: D138.3, D139.1
LD39: D137.3, D138.1
LD40: D136.3, D137.1
LD41: D124.3, D136.1
LD42: D124.1, D125.3
LD43: D125.1, D126.3
LD44: D126.1, D127.3
LD45: D127.1, D128.3
LED_DIN: D116.3, U1.45
LED_EN: Q4.1, R12.1, U1.7
LED_G: Q3.1, Q4.3, R9.2
MUXA: U1.10, U10.1
MUXB: U1.12, U11.1
MUXC: U1.14, U12.1
PRESS1: J2.11, U10.9
PRESS2: J3.4, U12.16
QI5V: D2.2, TP1.1
RESET: TP22.1, U1.40
S0: U1.16, U10.10, U11.10, U12.10
S1: U1.22, U10.11, U11.11, U12.11
S2: U1.24, U10.14, U11.14, U12.14
S3: U1.26, U10.13, U11.13, U12.13
SCL: TP12.1, U1.38
SDA: TP13.1, U1.36
SENSE_EN: Q1.1, R7.2, U1.5
SO_0_0: R100.1, U100.2
SO_0_1: R112.2, U112.2
SO_0_2: R124.1, U124.2
SO_1_0: R101.1, U101.2
SO_1_1: R113.2, U113.2
SO_1_2: R125.1, U125.2
SO_1_3: R136.2, U136.2
SO_2_0: R102.1, U102.2
SO_2_1: R114.2, U114.2
SO_2_2: R126.1, U126.2
SO_2_3: R137.2, U137.2
SO_3_0: R103.1, U103.2
SO_3_1: R115.2, U115.2
SO_3_2: R127.1, U127.2
SO_3_3: R138.2, U138.2
SO_4_0: R104.1, U104.2
SO_4_1: R116.2, U116.2
SO_4_2: R128.1, U128.2
SO_4_3: R139.2, U139.2
SO_5_0: R105.1, U105.2
SO_5_1: R117.2, U117.2
SO_5_2: R129.1, U129.2
SO_5_3: R140.2, U140.2
SO_6_0: R106.1, U106.2
SO_6_1: R118.2, U118.2
SO_6_2: R130.1, U130.2
SO_6_3: R141.2, U141.2
SO_7_0: R107.1, U107.2
SO_7_1: R119.2, U119.2
SO_7_2: R131.1, U131.2
SO_7_3: R142.2, U142.2
SO_8_0: R108.1, U108.2
SO_8_1: R120.2, U120.2
SO_8_2: R132.1, U132.2
SO_8_3: R143.2, U143.2
SO_9_0: R109.1, U109.2
SO_9_1: R121.2, U121.2
SO_9_2: R133.1, U133.2
SO_9_3: R144.2, U144.2
SO_10_0: R110.1, U110.2
SO_10_1: R122.2, U122.2
SO_10_2: R134.1, U134.2
SO_10_3: R145.2, U145.2
SO_11_0: R111.1, U111.2
SO_11_1: R123.2, U123.2
SO_11_2: R135.1, U135.2
SWCLK: TP21.1, U1.53
SWDIO: TP20.1, U1.51
TS: R5.1, U4.1
USB_DM: J1.A7, J1.B7, U1.34, U3.3, U3.4
USB_DP: J1.A6, J1.B6, U1.35, U3.1, U3.6
VBAT: C5.1, J4.1, R10.1, U4.2, U4.3
VBAT_SNS: C12.1, R10.2, R11.1, U1.20
VBUS: C3.1, D1.2, J1.A4, J1.A9, J1.B4, J1.B9, U1.32, U3.5
VIN: C4.1, D1.1, D2.1, R6.2, U4.13
VLED: C9.1, C200.1, C201.1, C202.1, C203.1, C204.1, C205.1, C206.1, C207.1, C208.1, C209.1, C210.1, C211.1, C212.1, C213.1, C214.1, C215.1, C216.1, C217.1, C218.1, C219.1, C220.1, C221.1, C222.1, C223.1, C224.1, C225.1, C226.1, C228.1, C229.1, C230.1, C231.1, C232.1, C233.1, C234.1, C235.1, C236.1, C237.1, C238.1, C239.1, C240.1, C241.1, C242.1, C243.1, C244.1, C245.1, D100.4, D101.4, D102.4, D103.4, D104.4, D105.4, D106.4, D107.4, D108.4, D109.4, D110.4, D111.4, D112.4, D113.4, D114.4, D115.4, D116.4, D117.4, D118.4, D119.4, D120.4, D121.4, D122.4, D123.4, D124.4, D125.4, D126.4, D127.4, D128.4, D129.4, D130.4, D131.4, D132.4, D133.4, D134.4, D135.4, D136.4, D137.4, D138.4, D139.4, D140.4, D141.4, D142.4, D143.4, D144.4, D145.4, Q3.3
VSENSE: C8.1, C100.1, C101.1, C102.1, C103.1, C104.1, C105.1, C106.1, C107.1, C108.1, C109.1, C110.1, C111.1, C112.1, C113.1, C114.1, C115.1, C116.1, C117.1, C118.1, C119.1, C120.1, C121.1, C122.1, C123.1, C124.1, C125.1, C126.1, C127.1, C128.1, C129.1, C130.1, C131.1, C132.1, C133.1, C134.1, C135.1, C136.1, C137.1, C138.1, C139.1, C140.1, C141.1, C142.1, C143.1, C144.1, C145.1, Q1.3, U100.1, U101.1, U102.1, U103.1, U104.1, U105.1, U106.1, U107.1, U108.1, U109.1, U110.1, U111.1, U112.1, U113.1, U114.1, U115.1, U116.1, U117.1, U118.1, U119.1, U120.1, U121.1, U122.1, U123.1, U124.1, U125.1, U126.1, U127.1, U128.1, U129.1, U130.1, U131.1, U132.1, U133.1, U134.1, U135.1, U136.1, U137.1, U138.1, U139.1, U140.1, U141.1, U142.1, U143.1, U144.1, U145.1
VSYS: C6.1, C20.1, C21.1, J2.1, J2.2, J2.3, J3.12, J3.13, J3.14, Q3.2, R9.1, U4.10, U4.11, U5.3
