haokun12x/best-key/(commit log)

2026-11-12 BK46: 46-key ortho keyboard with dual haptic knobs — case, PCBs, fab files, homepage
    [01_plate_1.5mm.dxf, 02_bezel_top_view.dxf, 03_tub_section_z4.6.dxf, 04_tub_floor_holes.dxf, 05_gasket_positions_x2.dxf, 06_plate_foam_3mm.dxf, 07_floor_layout.dxf, bezel.step]
2026-11-12 Homepage: knob module section — flexure board, section/assembly, FFC interconnect
2026-11-12 Homepage: magnet placement explainer, MCU interconnect map, display mounting and wiring
